pa-pa/HMRemote/README.md

# HMRemote

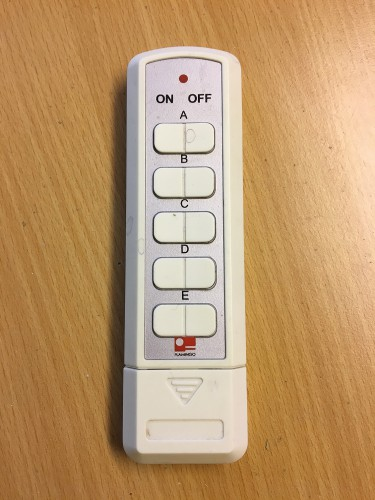
[picture p1: files/fb1.JPG]
fb

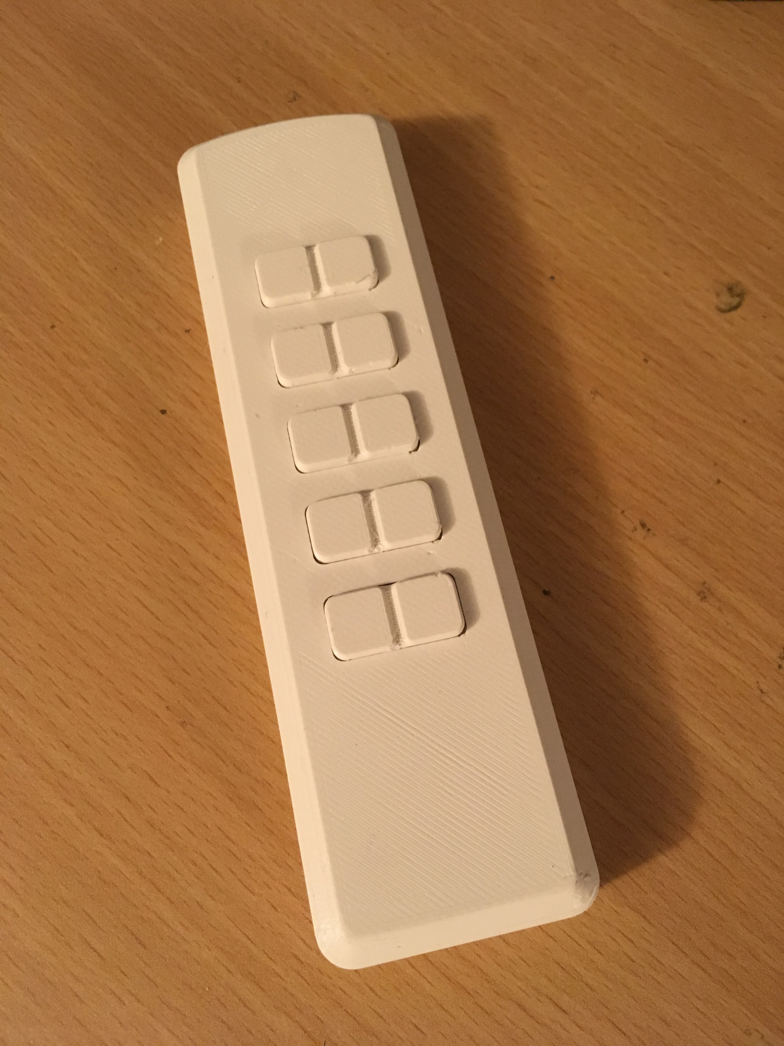
[picture p2: files/case.jpg]
Case

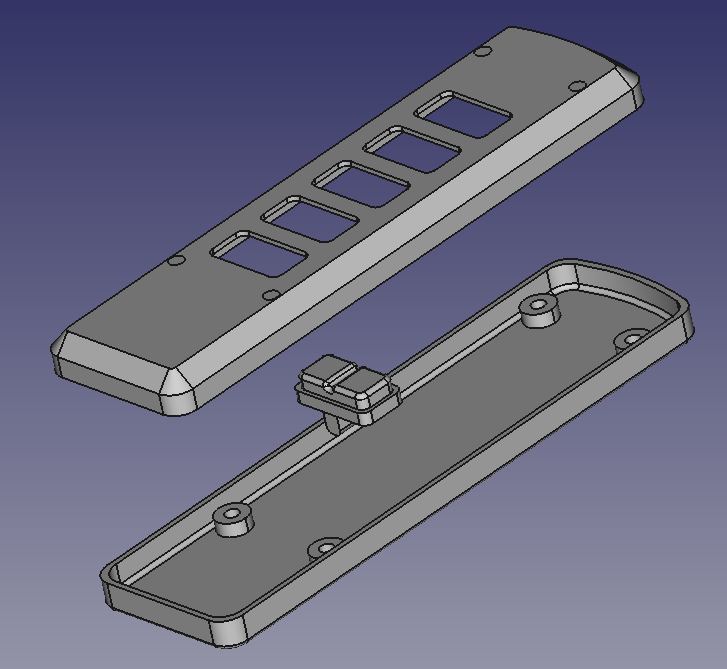
[picture p3: files/case_freecad.png]
Case FreeCad

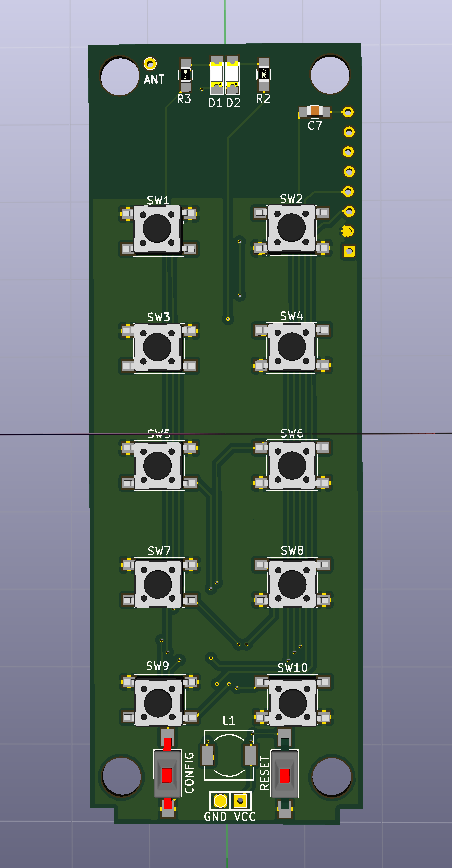
[picture p4: files/front.png]
front

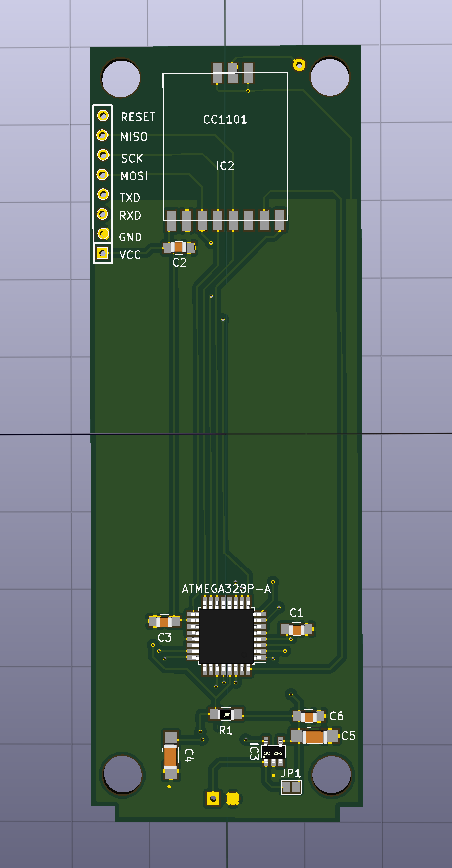
[picture p5: files/back.png]
back
