pa-pa/HMRemote/files/fb2.JPG

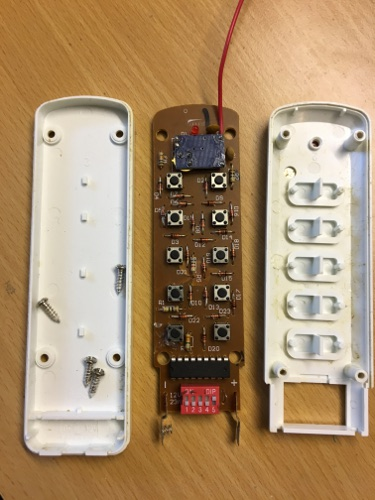
files/fb2.JPG
