pa-pa/HMRemote/files/fb3.JPG

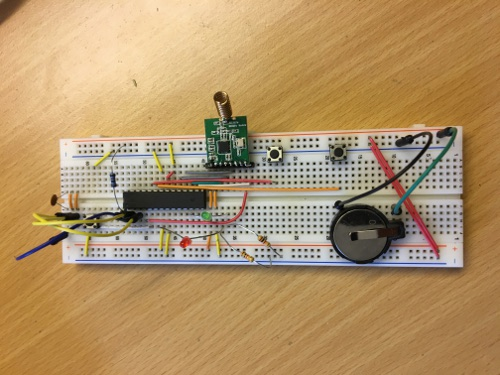
files/fb3.JPG
