pa-pa/HMRemote/freecad/CaseTop.stl

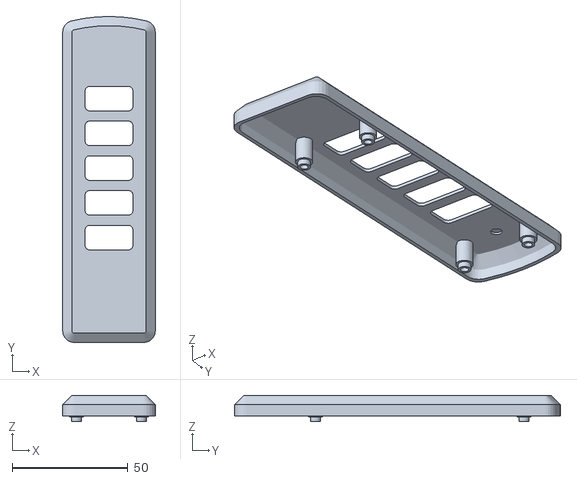
[picture p8: CAD file, 2019-03-13]
freecad/CaseTop.stl
40.0 x 140.8 x 11.4
