pa-pa/HMRemote/freecad/CaseBottom.stl

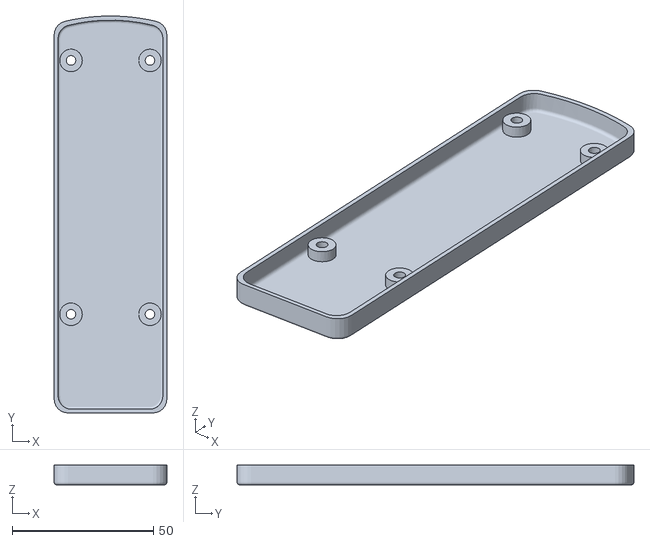
[picture p9: CAD file, 2019-03-13]
freecad/CaseBottom.stl
40.0 x 140.8 x 7.00
