pa-pa/HMRemote/freecad/Button.stl

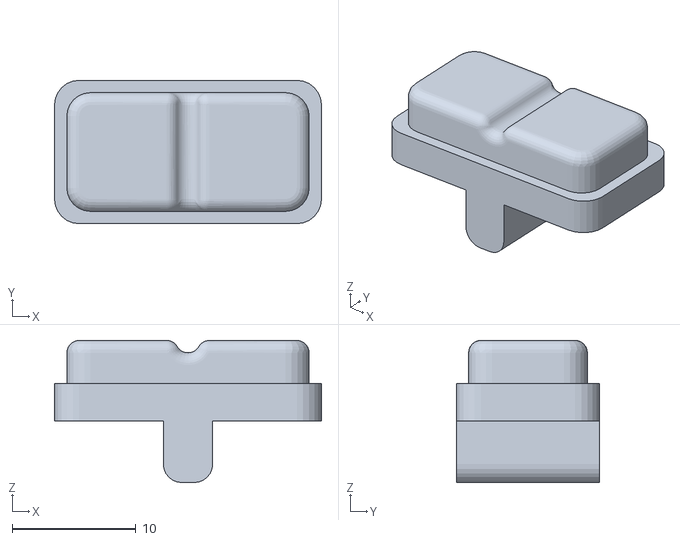
[picture p10: CAD file, 2019-03-13]
freecad/Button.stl
21.6 x 11.6 x 11.5
