pa-pa/HMRemote/freecad/Remote.FCStd

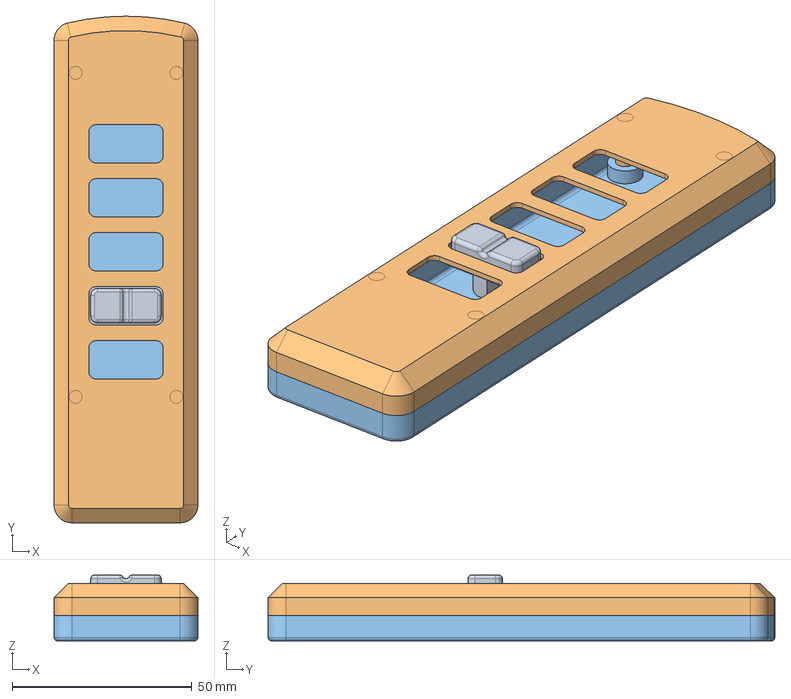
[picture p11: CAD file, 2019-03-13]
freecad/Remote.FCStd
40.0 x 140.8 x 18.3 mm
Button
CaseTop
CaseBottom
