pa-pa/HMRemote/files/remote.pdf

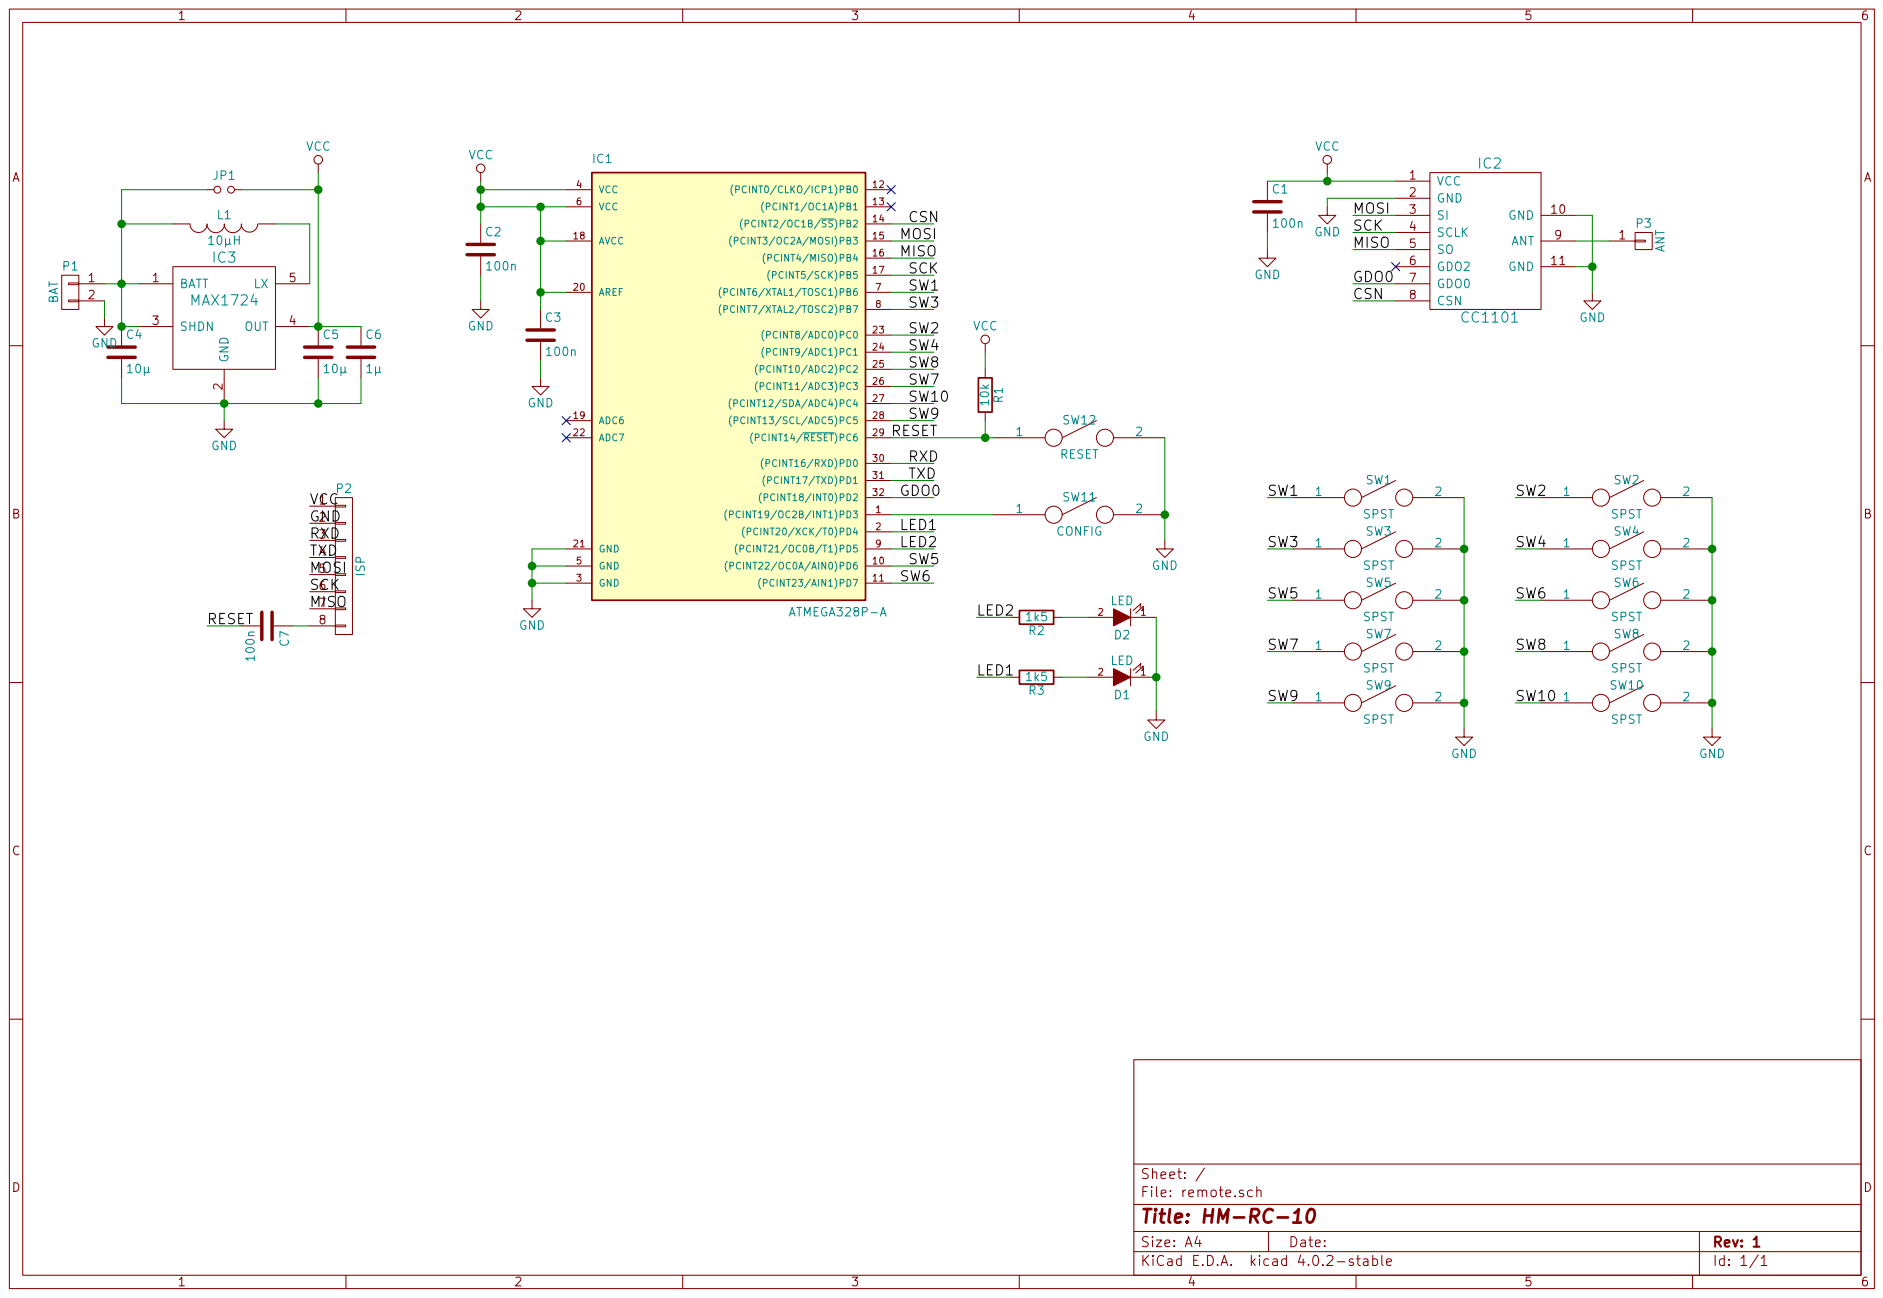
[picture p12: page 1]

File: remote.sch Sheet: /
Id: 1/1 Title: HM-RC-10
