pa-pa/HMRemote/kicad/remote.kicad_pcb

## KiCad design kicad/remote.kicad_pcb (2019-03-13)

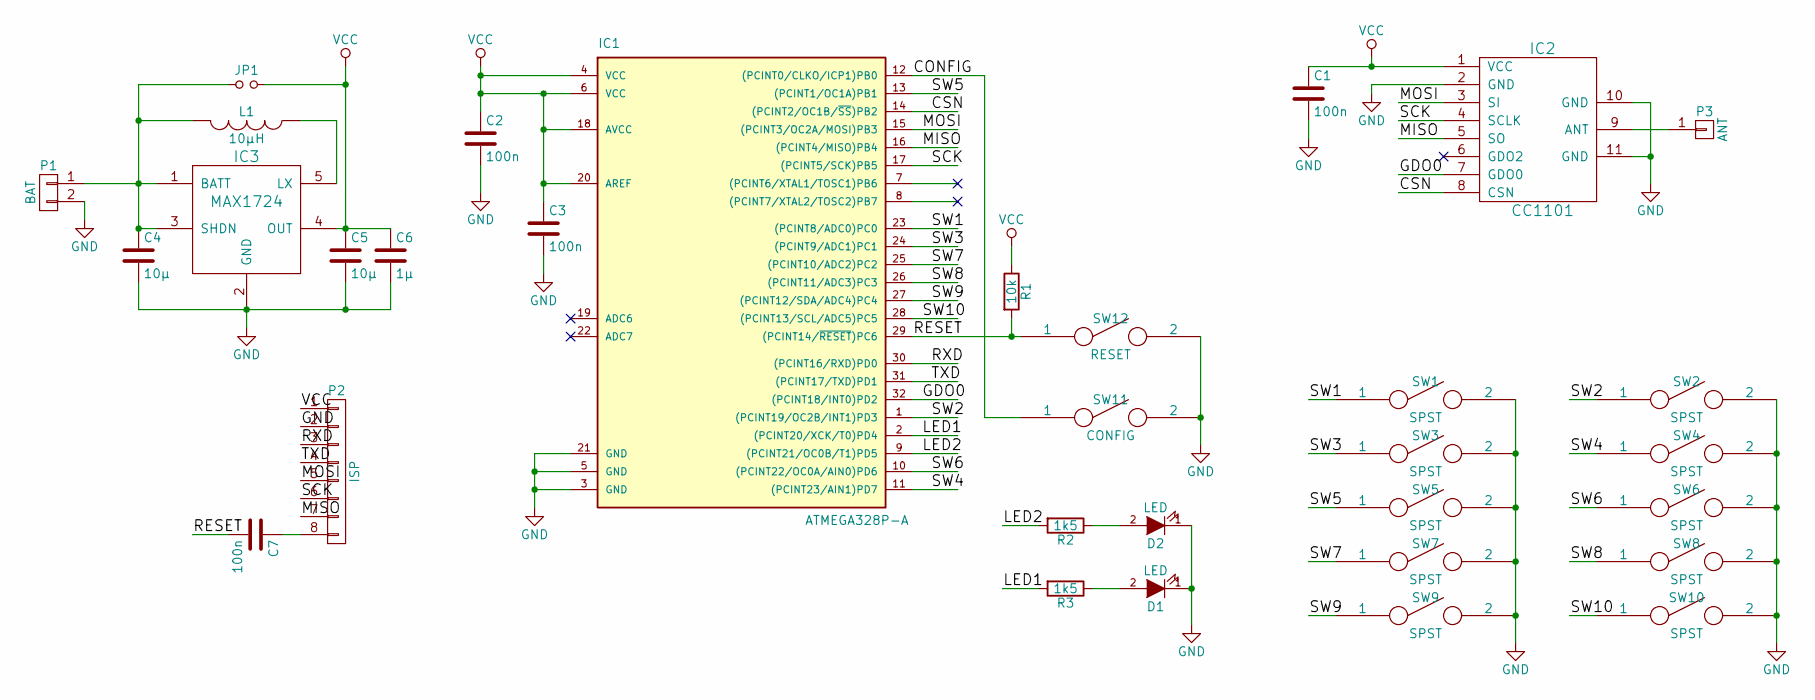
[picture p13: schematic remote.sch, HM-RC-10]

Parts:
C1, C2, C3, C7: 100n; C_0805_HandSoldering
C4, C5: 10µ; C_1206_HandSoldering
C6: 1µ; C_0805_HandSoldering
D1, D2: LED; LED_1206
IC1: ATMEGA328P-A; TQFP-32_7x7mm_Pitch0.8mm
IC2: CC1101; CC1101_Module
IC3: MAX1724; SOT-23-5
JP1: Jumper_NO_Small; GS2
L1: 10µH; Choke_SMD_6.3x6.3_H3
P1: BAT; CONN_2.54mm_1x2
P2: ISP; CONN_2.54mm_1x8
P3: ANT; CONN_2.54mm_1x1
R1: 10k; R_0805_HandSoldering
R2, R3: 1k5; R_0805_HandSoldering
SW1, SW2, SW3, SW4, SW5, SW6, SW7, SW8, SW9, SW10: SPST; SW_SPST_PTS645
SW11: CONFIG; SW_SPST_FSMSM
SW12: RESET; SW_SPST_FSMSM

Connections:
/CONFIG: IC1.12 ((PCINT0/CLKO/ICP1)PB0), SW11.1
/CSN: IC1.14 ((PCINT2/OC1B/~SS~)PB2), IC2.8 (CSN)
/GDO0: IC1.32 ((PCINT18/INT0)PD2), IC2.7 (GDO0)
/LED1: IC1.2 ((PCINT20/XCK/T0)PD4), R3.2
/LED2: IC1.9 ((PCINT21/OC0B/T1)PD5), R2.2
/MISO: IC1.16 ((PCINT4/MISO)PB4), IC2.5 (SO), P2.7
/MOSI: IC1.15 ((PCINT3/OC2A/MOSI)PB3), IC2.3 (SI), P2.5
/RESET: C7.2, IC1.29 ((PCINT14/~RESET~)PC6), R1.2, SW12.1
/RXD: IC1.30 ((PCINT16/RXD)PD0), P2.3
/SCK: IC1.17 ((PCINT5/SCK)PB5), IC2.4 (SCLK), P2.6
/SW1: IC1.23 ((PCINT8/ADC0)PC0), SW1.1
/SW2: IC1.1 ((PCINT19/OC2B/INT1)PD3), SW2.1
/SW3: IC1.24 ((PCINT9/ADC1)PC1), SW3.1
/SW4: IC1.11 ((PCINT23/AIN1)PD7), SW4.1
/SW5: IC1.13 ((PCINT1/OC1A)PB1), SW5.1
/SW6: IC1.10 ((PCINT22/OC0A/AIN0)PD6), SW6.1
/SW7: IC1.25 ((PCINT10/ADC2)PC2), SW7.1
/SW8: IC1.26 ((PCINT11/ADC3)PC3), SW8.1
/SW9: IC1.27 ((PCINT12/SDA/ADC4)PC4), SW9.1
/SW10: IC1.28 ((PCINT13/SCL/ADC5)PC5), SW10.1
/TXD: IC1.31 ((PCINT17/TXD)PD1), P2.4
GND: C1.2, C2.2, C3.2, C4.2, C5.2, C6.2, D1.1 (K), D2.1 (K), IC1.3 (GND), IC1.5 (GND), IC1.21 (GND), IC2.2 (GND), IC2.10 (GND), IC2.11 (GND), IC3.2 (GND), P1.2, P2.2, SW1.2, SW2.2, SW3.2, SW4.2, SW5.2, SW6.2, SW7.2, SW8.2, SW9.2, SW10.2, SW11.2, SW12.2
unnamed: C4.1, IC3.1 (BATT), IC3.3 (SHDN), JP1.1, L1.2, P1.1
unnamed: C7.1, P2.8
unnamed: D1.2 (A), R3.1
unnamed: D2.2 (A), R2.1
unnamed: IC2.9 (ANT), P3.1
unnamed: IC3.5 (LX), L1.1
VCC: C1.1, C2.1, C3.1, C5.1, C6.1, IC1.4 (VCC), IC1.6 (VCC), IC1.18 (AVCC), IC1.20 (AREF), IC2.1 (VCC), IC3.4 (OUT), JP1.2, P2.1, R1.1

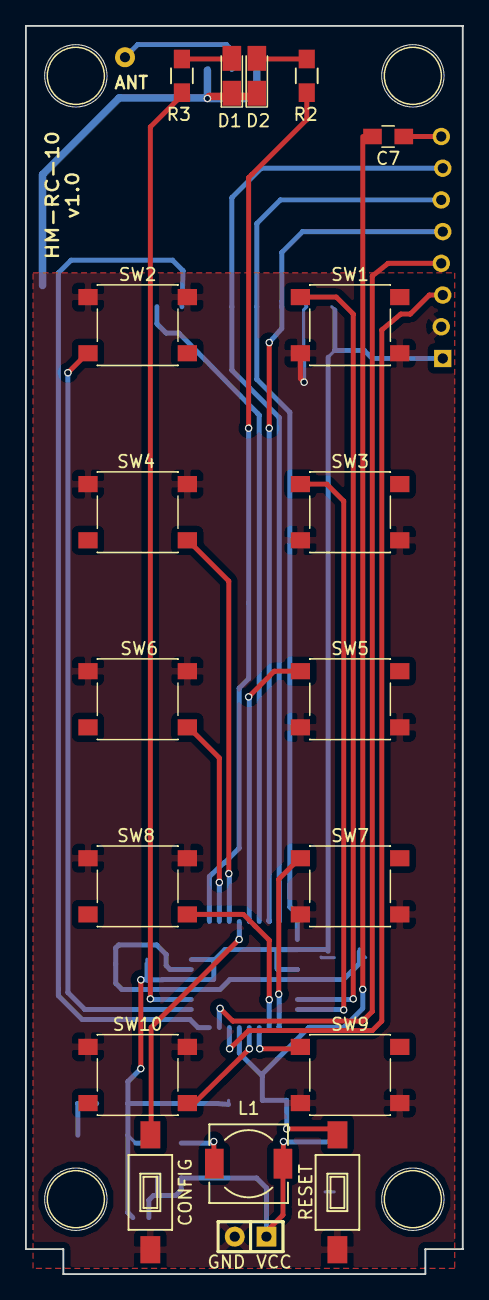
[picture p14: board remote.kicad_pcb from above]

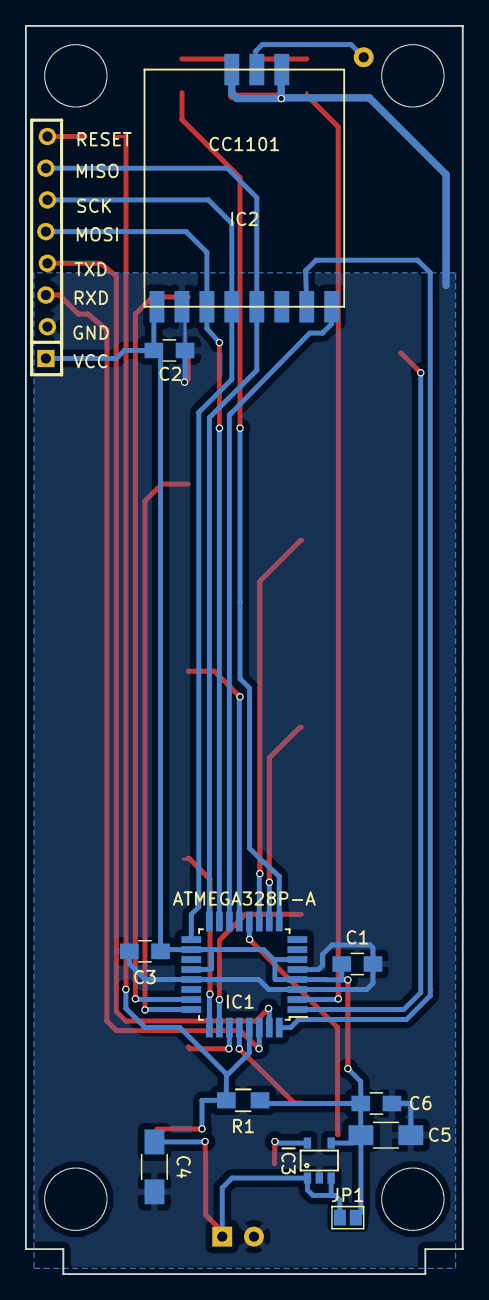
[picture p15: board remote.kicad_pcb from below]

Board: 2 copper layers, 35.0 x 100.0 mm, 32 parts (12 on the bottom side), 29 nets.
