pa-pa/HMRemote/(commit log)

2019-03-13 all files added
    [Button.stl, CaseBottom.stl, CaseTop.stl, Remote.FCStd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]
2019-03-13 kicad files moved into subdirectory firmware added
    [remote.kicad_pcb, remote.sch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]
